nmemmolo/Helmute/3D Models/Helmute Files/HELMUTE Main Enclosure v11.step

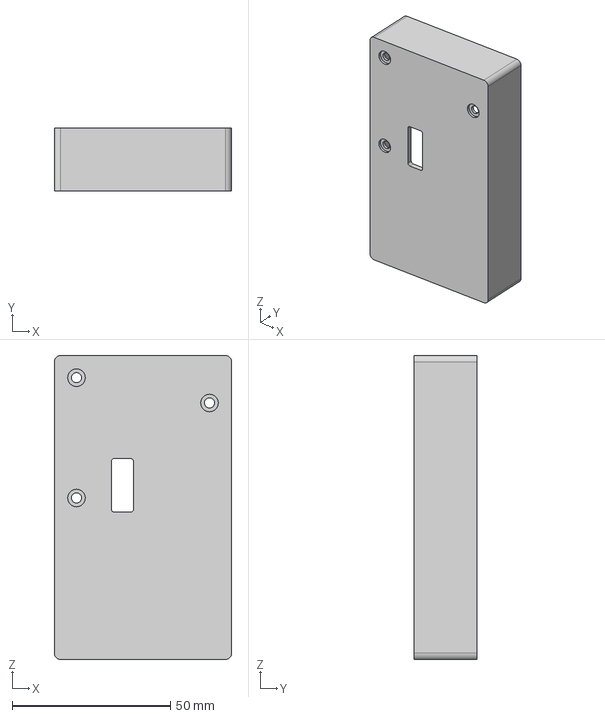
[picture p1: CAD file, 2025-05-15]
3D Models/Helmute Files/HELMUTE Main Enclosure v11.step
56.0 x 20.0 x 96.0 mm
