nmemmolo/Helmute/3D Models/Helmute Files/HELMUTE Mic Enclosure v13.step

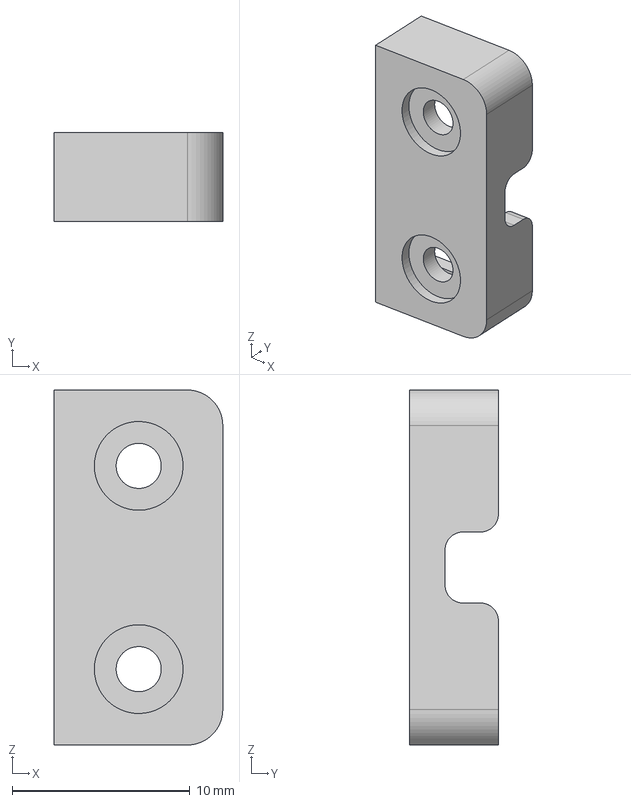
[picture p2: CAD file, 2025-05-15]
3D Models/Helmute Files/HELMUTE Mic Enclosure v13.step
9.50 x 5.00 x 20.0 mm
