nmemmolo/Helmute/3D Models/Helmute Files/HELMUTE Cradle Enclosure Perf Rev v1.step

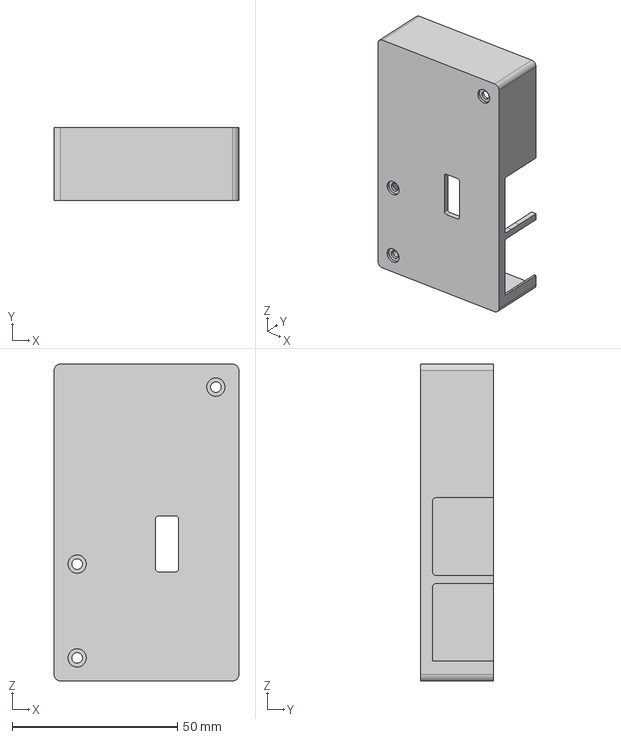
[picture p3: CAD file, 2025-05-15]
3D Models/Helmute Files/HELMUTE Cradle Enclosure Perf Rev v1.step
56.0 x 22.0 x 96.0 mm
