nmemmolo/Helmute/PCBs/Helmute_PCBs_revA/Helmute_PCBs.kicad_pcb

## KiCad design PCBs/Helmute_PCBs_revA/Helmute_PCBs.kicad_pcb (2025-03-11)

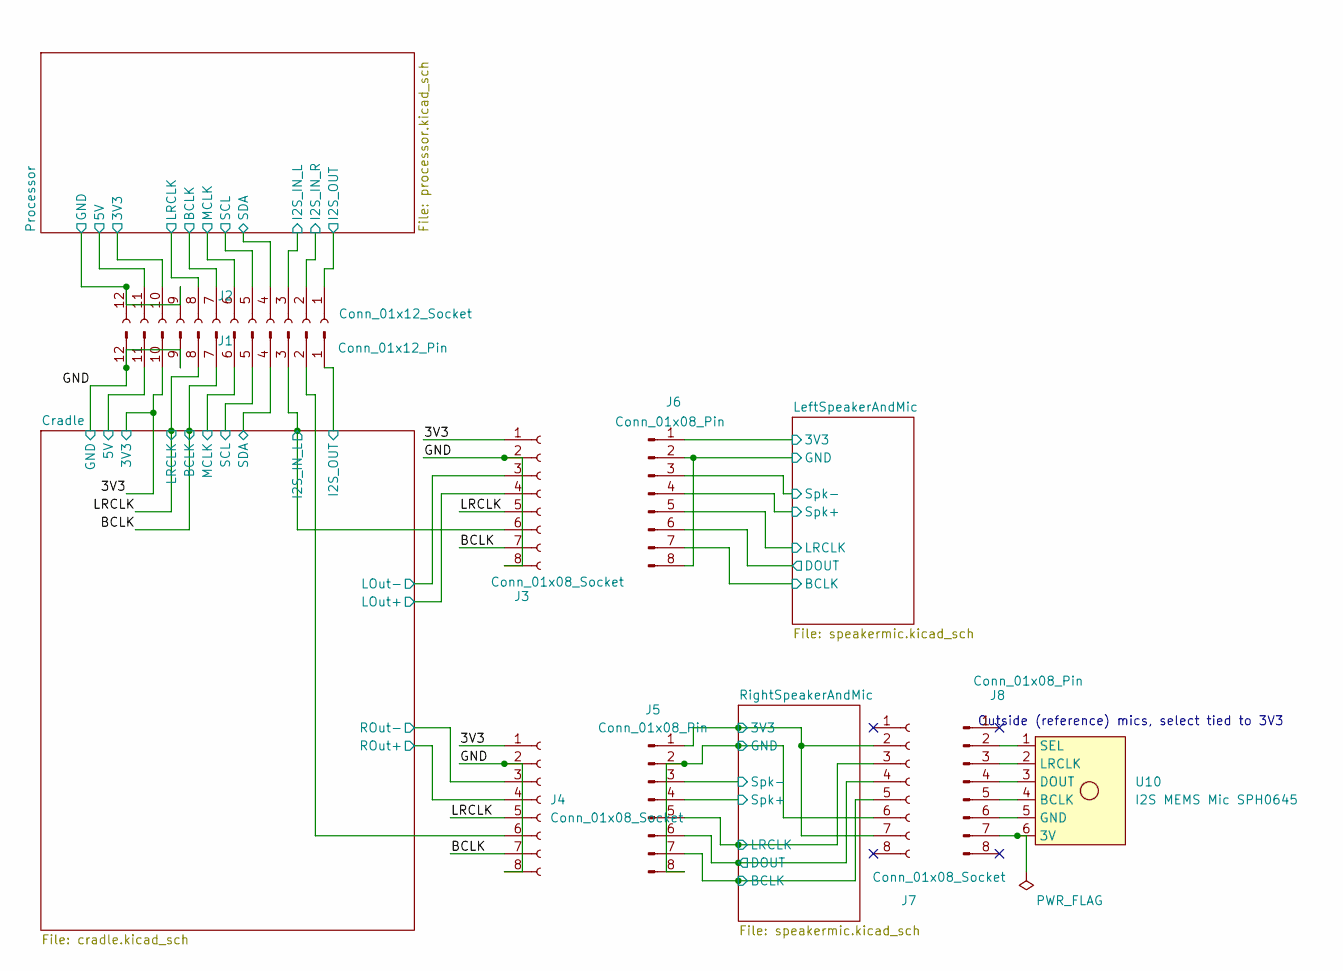
[picture p4: schematic Helmute_PCBs.kicad_sch]

Parts:
J1: Conn_01x12_Socket; PinHeader_2x06_P2.54mm_Vertical
J2: Conn_01x12_Pin; PinHeader_2x06_P2.54mm_Vertical
J3, J4, J7: Conn_01x08_Socket; JST_XH_S8B-XH-A_1x08_P2.50mm_Horizontal
J5, J6, J8: Conn_01x08_Pin; JST_XH_S8B-XH-A_1x08_P2.50mm_Horizontal
U10: I2S MEMS Mic SPH0645; I2S SPK0415HM4H

Connections:
/3V3: J2.10, J3.1, J4.1; also elsewhere on the board
/BCLK: J2.7, J3.7, J4.7; also elsewhere on the board
/Cradle/5V_CRD: J2.11; also elsewhere on the board
/Cradle/I2S_IN_L: J2.3, J3.6; also elsewhere on the board
/Cradle/I2S_OUT1: J2.1; also elsewhere on the board
/Cradle/LOut+: J3.4; also elsewhere on the board
/Cradle/LOut-: J3.3; also elsewhere on the board
/Cradle/MCLK1: J2.6; also elsewhere on the board
/Cradle/ROut+: J4.4; also elsewhere on the board
/Cradle/ROut-: J4.3; also elsewhere on the board
/Cradle/SCL: J2.5; also elsewhere on the board
/Cradle/SDA: J2.4; also elsewhere on the board
/GND: J2.9, J2.12, J3.2, J3.8, J4.2, J4.8; also elsewhere on the board
/LRCLK: J2.8, J3.5, J4.5; also elsewhere on the board
/Processor/3V3: J1.10; also elsewhere on the board
/Processor/5V_MCU: J1.11; also elsewhere on the board
/Processor/GND_MCU: J1.9, J1.12; also elsewhere on the board
/Processor/I2S_BCLK: J1.7; also elsewhere on the board
/Processor/I2S_IN_L: J1.3; also elsewhere on the board
/Processor/I2S_IN_R: J1.2; also elsewhere on the board
/Processor/I2S_LRCLK: J1.8; also elsewhere on the board
/Processor/I2S_OUT: J1.1; also elsewhere on the board
/Processor/MCLK: J1.6; also elsewhere on the board
/Processor/SCL: J1.5; also elsewhere on the board
/Processor/SDA: J1.4; also elsewhere on the board
/RightSpeakerAndMic/3V3_SPK: J5.1, J7.2, J7.7; also elsewhere on the board
/RightSpeakerAndMic/BCLK: J5.7, J7.5; also elsewhere on the board
/RightSpeakerAndMic/DOUT: J5.6, J7.4; also elsewhere on the board
/RightSpeakerAndMic/GND_SPK: J5.2, J5.8, J7.6; also elsewhere on the board
/RightSpeakerAndMic/LRCLK: J5.5, J7.3; also elsewhere on the board
/RightSpeakerAndMic/Spk+: J5.4; also elsewhere on the board
/RightSpeakerAndMic/Spk-: J5.3; also elsewhere on the board
unnamed: J2.2, J4.6
unnamed: J6.2, J6.8
unnamed: J8.2, U10.1 (SEL)
unnamed: J8.3, U10.2 (LRCLK)
unnamed: J8.4, U10.3 (DOUT)
unnamed: J8.5, U10.4 (BCLK)
unnamed: J8.6, U10.5 (GND)
unnamed: J8.7, U10.6 (3V)

Notes on the sheet:
Outside (reference) mics, select tied to 3V3

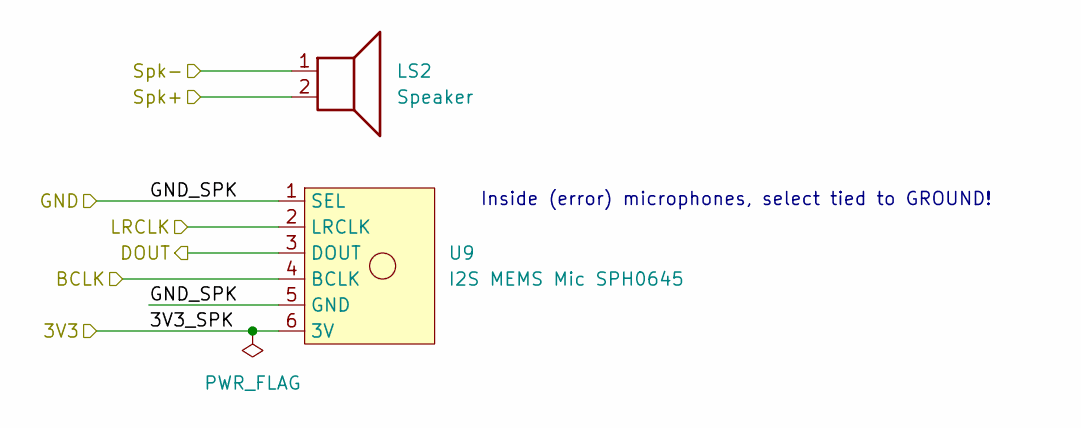
[picture p5: schematic speakermic.kicad_sch]

Parts:
LS2: Speaker; SpeakerConnections
U9: I2S MEMS Mic SPH0645; I2S SPK0415HM4H

Parts of its further copies:
LS1: Speaker; SpeakerConnections
U8: I2S MEMS Mic SPH0645; I2S SPK0415HM4H

Connections of its further copies:
/RightSpeakerAndMic/3V3_SPK: U8.6 (3V); also elsewhere on the board
/RightSpeakerAndMic/BCLK: U8.4 (BCLK); also elsewhere on the board
/RightSpeakerAndMic/DOUT: U8.3 (DOUT); also elsewhere on the board
/RightSpeakerAndMic/GND_SPK: U8.1 (SEL), U8.5 (GND); also elsewhere on the board
/RightSpeakerAndMic/LRCLK: U8.2 (LRCLK); also elsewhere on the board
/RightSpeakerAndMic/Spk+: LS1.2; also elsewhere on the board
/RightSpeakerAndMic/Spk-: LS1.1; also elsewhere on the board

Notes on the sheet:
Inside (error) microphones, select tied to GROUND!

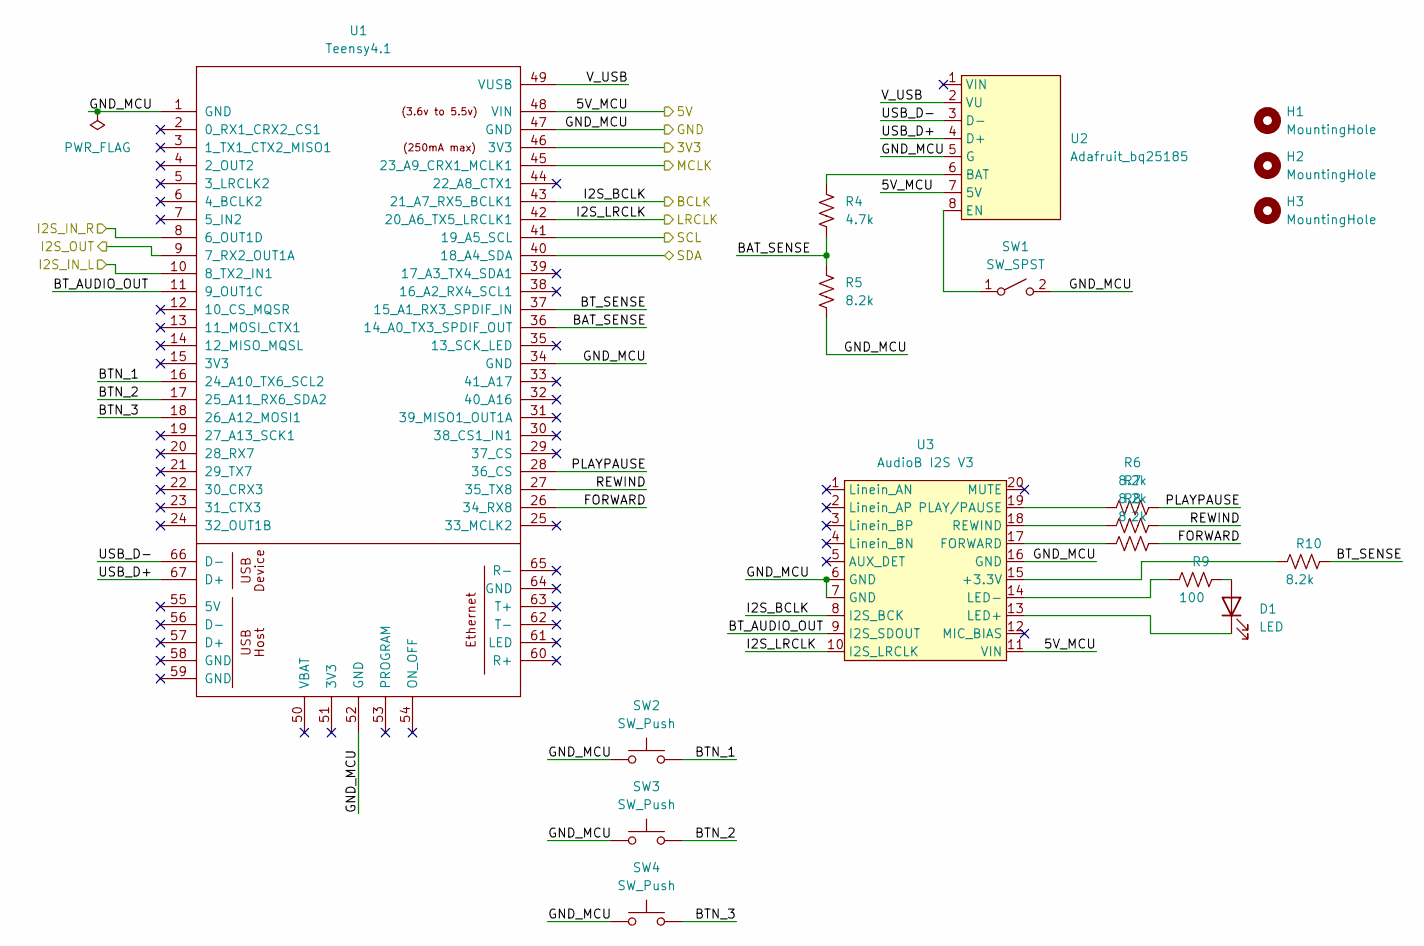
[picture p6: schematic processor.kicad_sch]

Parts:
D1: LED; LED_D5.0mm
H1, H2, H3: MountingHole; MountingHole_3.2mm_M3
R4: 4.7k; R_0805_2012Metric
R5, R6, R7, R8, R10: 8.2k; R_0805_2012Metric
R9: 100; R_0805_2012Metric
SW1: SW_SPST; SW_Slide_SPDT_Angled_CK_OS102011MA1Q
SW2, SW3, SW4: SW_Push; SW_PUSH_6mm
U1: Teensy4.1; Teensy41
U2: Adafruit_bq25185; bq25185 5V Boost Breakout
U3: AudioB I2S V3; AudioB

Connections:
/Processor/3V3: U1.46 (3V3); also elsewhere on the board
/Processor/5V_MCU: U1.48 (VIN), U2.7 (5V), U3.11 (VIN); also elsewhere on the board
/Processor/BAT_SENSE: R4.2, R5.1, U1.36 (14_A0_TX3_SPDIF_OUT)
/Processor/BTN_1: SW2.2, U1.16 (24_A10_TX6_SCL2)
/Processor/BTN_2: SW3.2, U1.17 (25_A11_RX6_SDA2)
/Processor/BTN_3: SW4.2, U1.18 (26_A12_MOSI1)
/Processor/BT_AUDIO_OUT: U1.11 (9_OUT1C), U3.9 (I2S_SDOUT)
/Processor/BT_SENSE: R10.2, U1.37 (15_A1_RX3_SPDIF_IN)
/Processor/FORWARD: R8.2, U1.26 (34_RX8)
/Processor/GND_MCU: R5.2, SW1.2 (B), SW2.1, SW3.1, SW4.1, U1.1 (GND), U1.34 (GND), U1.47 (GND), U1.52 (GND), U2.5 (G), U3.6 (GND), U3.7 (GND), U3.16 (GND); also elsewhere on the board
/Processor/I2S_BCLK: U1.43 (21_A7_RX5_BCLK1), U3.8 (I2S_BCK); also elsewhere on the board
/Processor/I2S_IN_L: U1.10 (8_TX2_IN1); also elsewhere on the board
/Processor/I2S_IN_R: U1.8 (6_OUT1D); also elsewhere on the board
/Processor/I2S_LRCLK: U1.42 (20_A6_TX5_LRCLK1), U3.10 (I2S_LRCLK); also elsewhere on the board
/Processor/I2S_OUT: U1.9 (7_RX2_OUT1A); also elsewhere on the board
/Processor/MCLK: U1.45 (23_A9_CRX1_MCLK1); also elsewhere on the board
/Processor/PLAYPAUSE: R6.2, U1.28 (36_CS)
/Processor/REWIND: R7.2, U1.27 (35_TX8)
/Processor/SCL: U1.41 (19_A5_SCL); also elsewhere on the board
/Processor/SDA: U1.40 (18_A4_SDA); also elsewhere on the board
/Processor/USB_D+: U1.67 (D+), U2.4 (D+)
/Processor/USB_D-: U1.66 (D-), U2.3 (D-)
/Processor/V_USB: U1.49 (VUSB), U2.2 (VU)
unnamed: D1.2 (A), R9.2
unnamed: D1.1 (K), U3.13 (LED+)
unnamed: SW1.1 (A), U2.8 (EN)
unnamed: R4.1, U2.6 (BAT)
unnamed: R10.1, U3.15 (+3.3V)
unnamed: R8.1, U3.17 (FORWARD)
unnamed: R9.1, U3.14 (LED-)
unnamed: R6.1, U3.19 (PLAY/PAUSE)
unnamed: R7.1, U3.18 (REWIND)

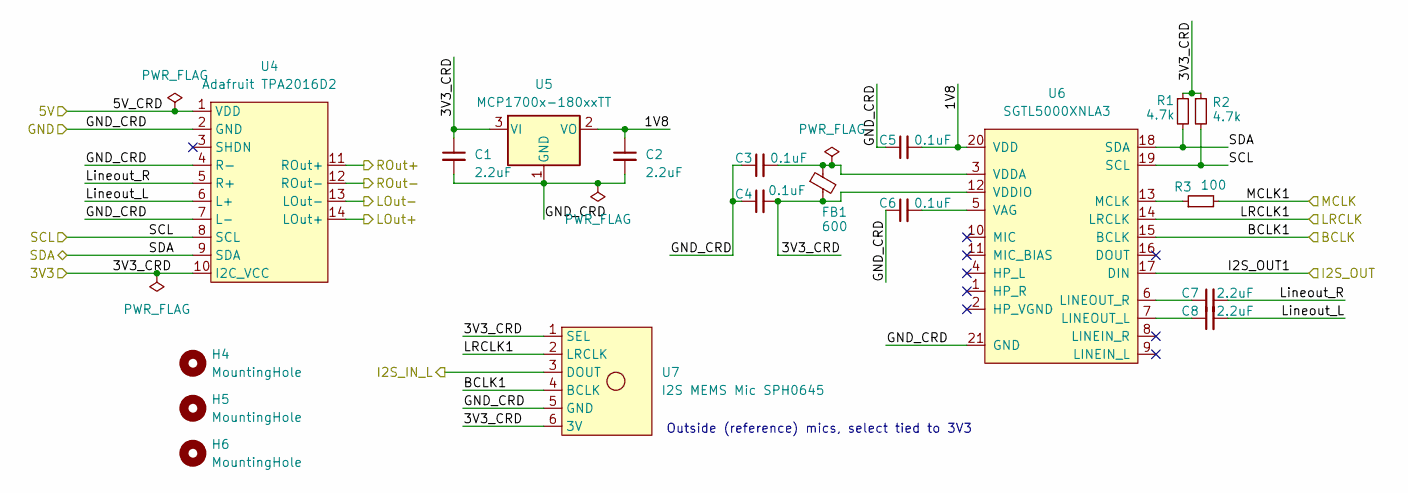
[picture p7: schematic cradle.kicad_sch]

Parts:
C1, C2, C7, C8: 2.2uF; C_0805_2012Metric
C3, C4, C5, C6: 0.1uF; C_0805_2012Metric
FB1: 600; C_0805_2012Metric
H4, H5, H6: MountingHole; MountingHole_3.2mm_M3
R1, R2: 4.7k; R_0805_2012Metric
R3: 100; R_0805_2012Metric
U4: Adafruit TPA2016D2; TPA22016D2new
U5: MCP1700x-180xxTT; SOT-23
U6: SGTL5000XNLA3; QFN-20-1EP_3x3mm_P0.4mm_EP1.65x1.65mm
U7: I2S MEMS Mic SPH0645; I2S SPK0415HM4H

Connections:
/3V3: C1.1, C4.2, FB1.2, R1.1, R2.1, U4.10 (I2C_VCC), U5.3 (VI), U6.12 (VDDIO), U7.1 (SEL), U7.6 (3V); also elsewhere on the board
/BCLK: U6.15 (BCLK), U7.4 (BCLK); also elsewhere on the board
/Cradle/1V8: C2.1, C5.2, U5.2 (VO), U6.20 (VDD)
/Cradle/5V_CRD: U4.1 (VDD); also elsewhere on the board
/Cradle/I2S_IN_L: U7.3 (DOUT); also elsewhere on the board
/Cradle/I2S_OUT1: U6.17 (DIN); also elsewhere on the board
/Cradle/LOut+: U4.14 (LOut+); also elsewhere on the board
/Cradle/LOut-: U4.13 (LOut-); also elsewhere on the board
/Cradle/Lineout_L: C8.2, U4.6 (L+)
/Cradle/Lineout_R: C7.2, U4.5 (R+)
/Cradle/MCLK1: R3.2; also elsewhere on the board
/Cradle/ROut+: U4.11 (ROut+); also elsewhere on the board
/Cradle/ROut-: U4.12 (ROut-); also elsewhere on the board
/Cradle/SCL: R2.2, U4.8 (SCL), U6.19 (SCL); also elsewhere on the board
/Cradle/SDA: R1.2, U4.9 (SDA), U6.18 (SDA); also elsewhere on the board
/GND: C1.2, C2.2, C3.1, C4.1, C5.1, C6.1, U4.2 (GND), U4.4 (R-), U4.7 (L-), U5.1 (GND), U6.21 (GND), U7.5 (GND); also elsewhere on the board
/LRCLK: U6.14 (LRCLK), U7.2 (LRCLK); also elsewhere on the board
unnamed: C8.1, U6.7 (LINEOUT_L)
unnamed: C7.1, U6.6 (LINEOUT_R)
unnamed: R3.1, U6.13 (MCLK)
unnamed: C6.2, U6.5 (VAG)
unnamed: C3.2, FB1.1, U6.3 (VDDA)

Notes on the sheet:
Outside (reference) mics, select tied to 3V3

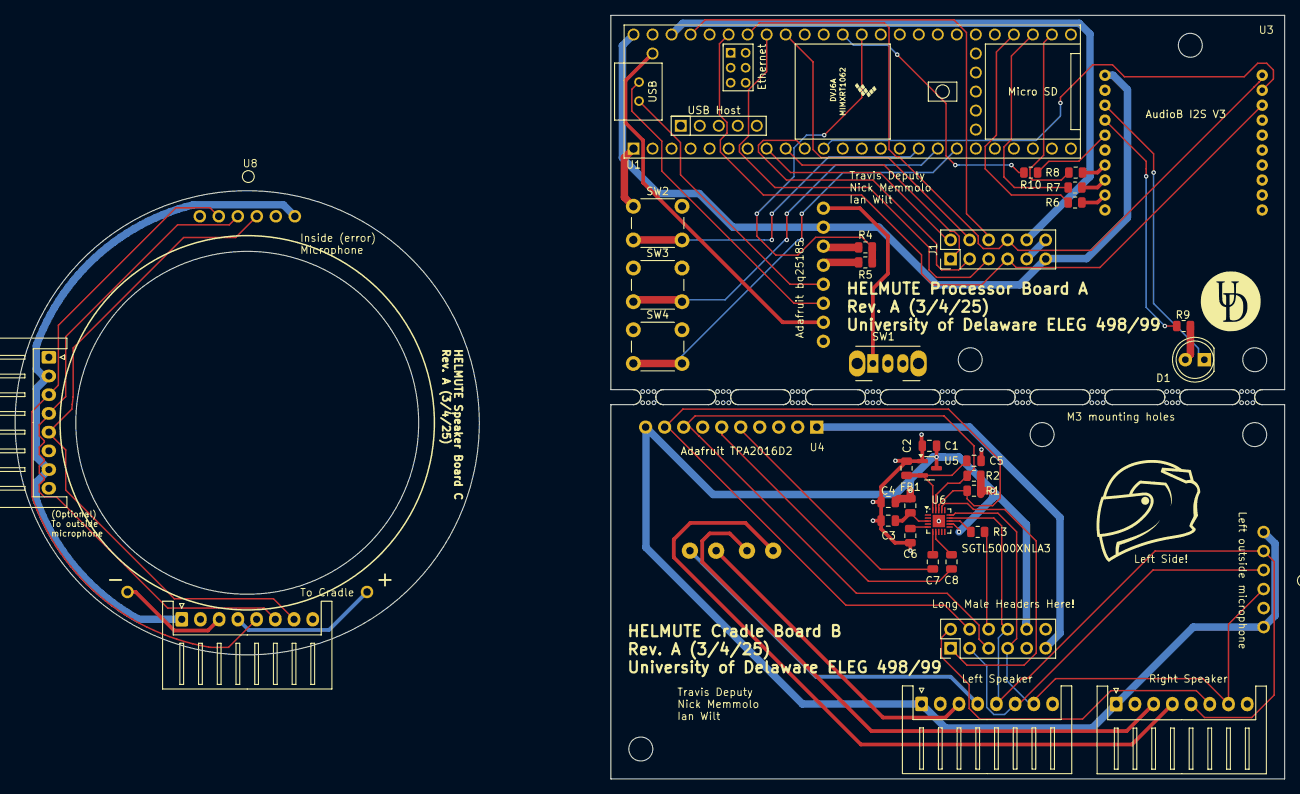
[picture p8: board Helmute_PCBs.kicad_pcb from above]

Board: 2 copper layers, 90.0 x 102.0 mm, 56 parts (0 on the bottom side), 62 nets.

Other parts of the board:
B1, B2: Board
mouse-bite-2mm-slot, mouse-bite-2mm-slot1, mouse-bite-2mm-slot2, mouse-bite-2mm-slot3, mouse-bite-2mm-slot4, mouse-bite-2mm-slot5, mouse-bite-2mm-slot6, mouse-bite-2mm-slot7, mouse-bite-2mm-slot8: VAL**; mouse-bite-2mm-slot
