nmemmolo/Helmute/(commit log)

2025-03-11 Create PCB Files
    storage space for custom PCB files
2025-03-11 Add things I worked on
    My code and PCB documents
    [Helmute_PCBs.kicad_pcb, Helmute_PCBs.kicad_sch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]
2025-05-15 Create Print Files
